Capteurs-Batiments/CapteursBatiments/doc/Montage.md

# Les circuits des différents capteurs.

## Capteur d’humidité et de température DHT11

CircuitCapteurDHT11

## Capteur de CO MQ-7

CircuitCapteurMQ7
